UTZbox/DCAA-Digitally-Controlled-Analog-Architecture/protoBoard/DCCA_proto_board_2.jpeg

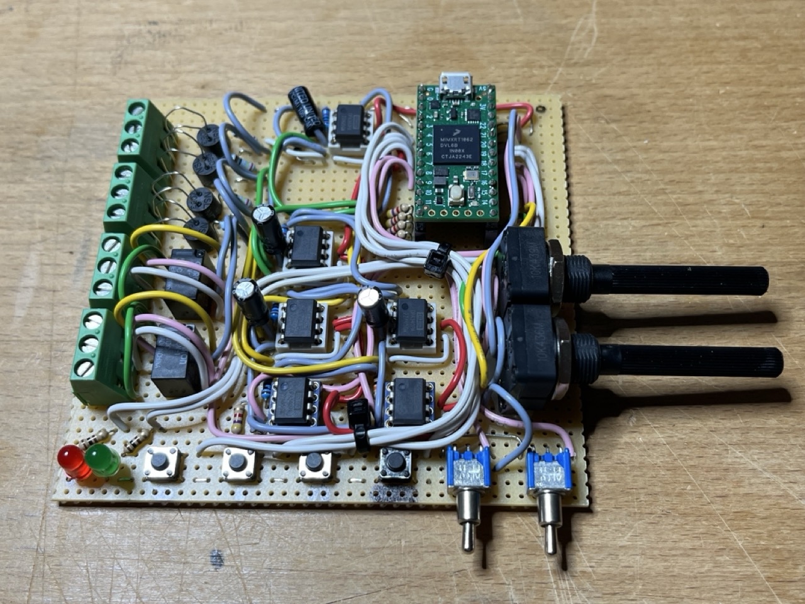
protoBoard/DCCA_proto_board_2.jpeg
