UTZbox/DCAA-Digitally-Controlled-Analog-Architecture/schematics/DCCA-Schematics.pdf

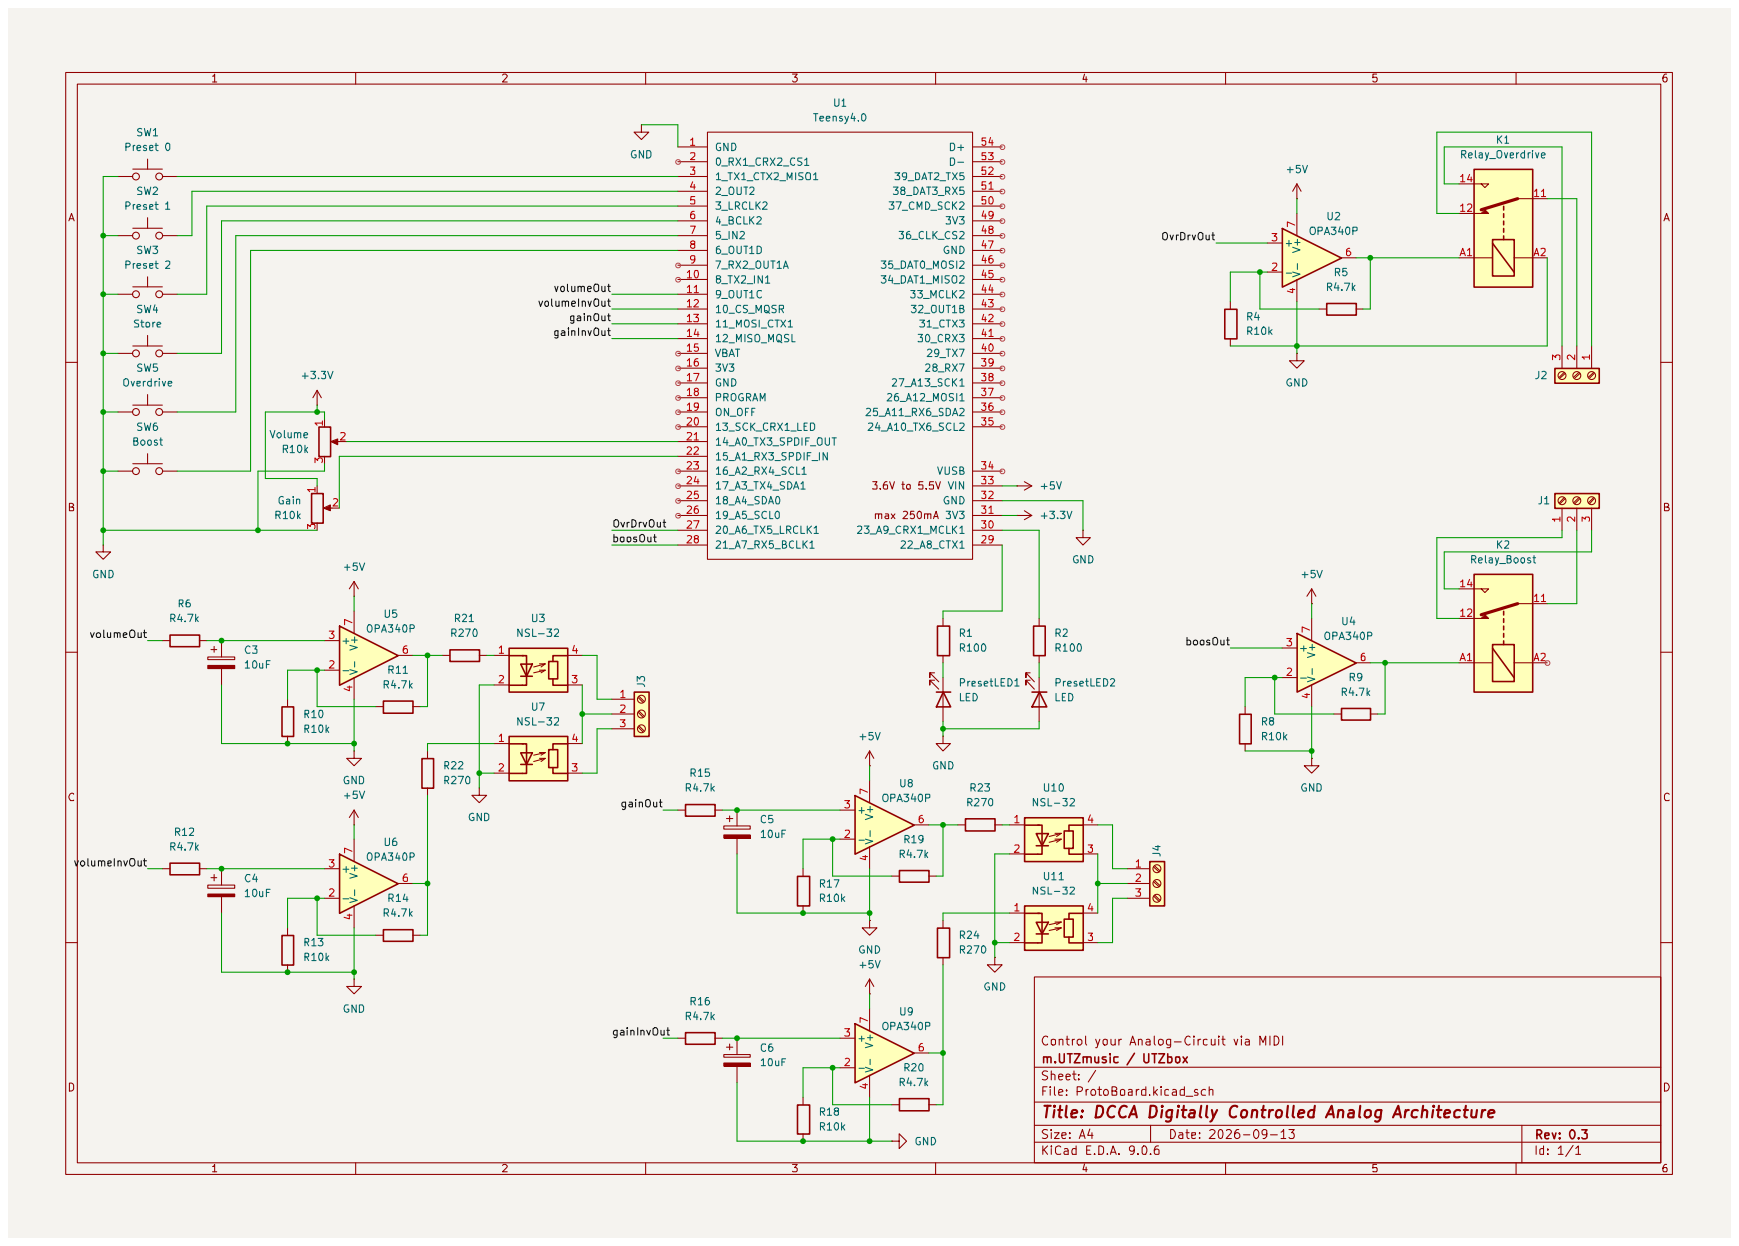
[picture p3: page 1]
