UTZbox/DCAA-Digitally-Controlled-Analog-Architecture/(commit log)

2026-10-29 Revise README with comprehensive project details
    Expanded the README to include detailed sections on overview, applications, features, startup, control modes, preset recall, saving presets, limitations, power supply, MIDI assignment, relay control, and credits.
2026-10-29 Add initial notes to schematics
2026-10-29 Mention Teensy 4 platform in README
    Added information about the Teensy 4 platform to the README.
